jeuceduhnisch/euroclock-slicer/hardware/examples/build-photos/07-preset-save-menu.jpg

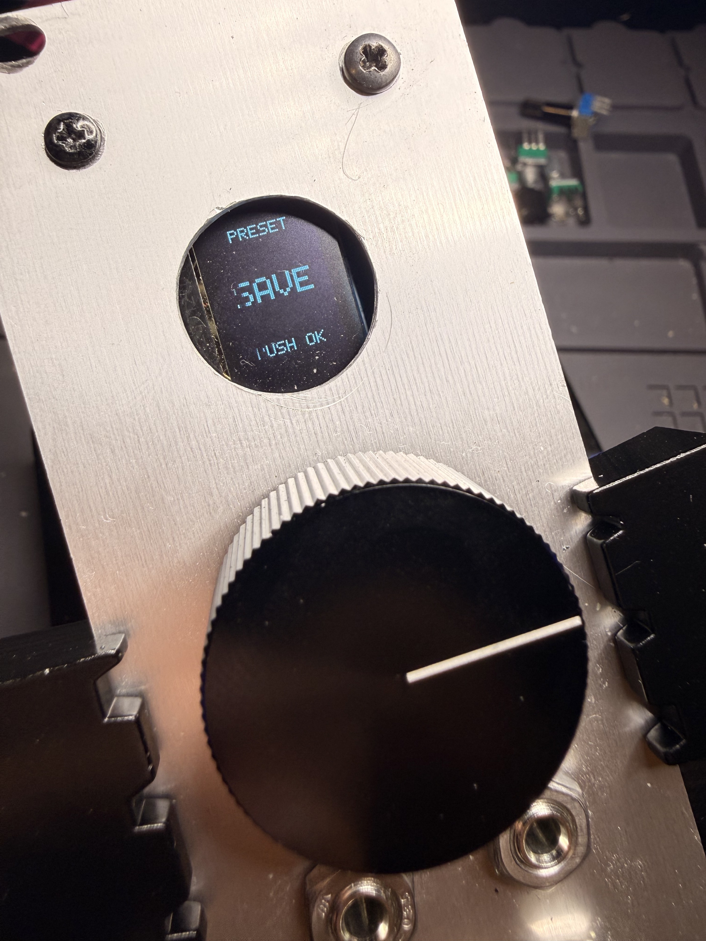
hardware/examples/build-photos/07-preset-save-menu.jpg
