jeuceduhnisch/euroclock-slicer/hardware/examples/build-photos/05-output-menu-time.jpg

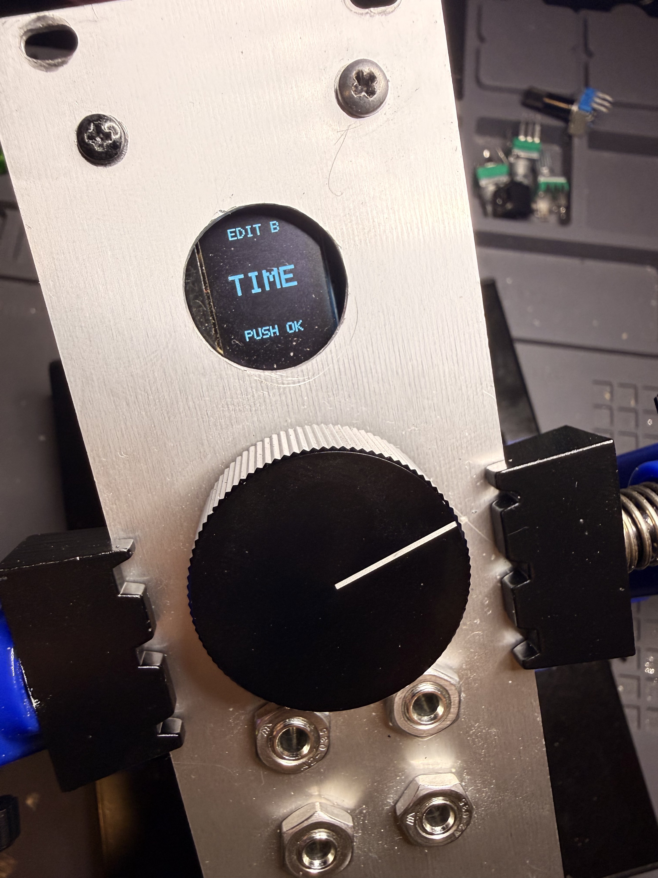
hardware/examples/build-photos/05-output-menu-time.jpg
