jeuceduhnisch/euroclock-slicer/hardware/examples/build-photos/01-front-panel-home.jpg

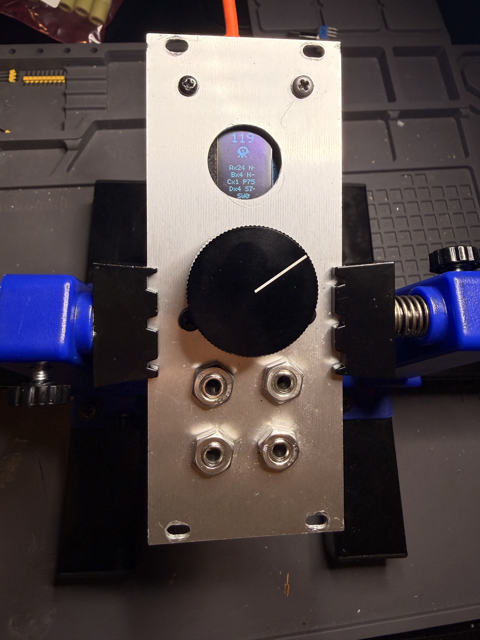
hardware/examples/build-photos/01-front-panel-home.jpg
