jeuceduhnisch/euroclock-slicer/hardware/examples/build-photos/02-main-board-wiring.jpg

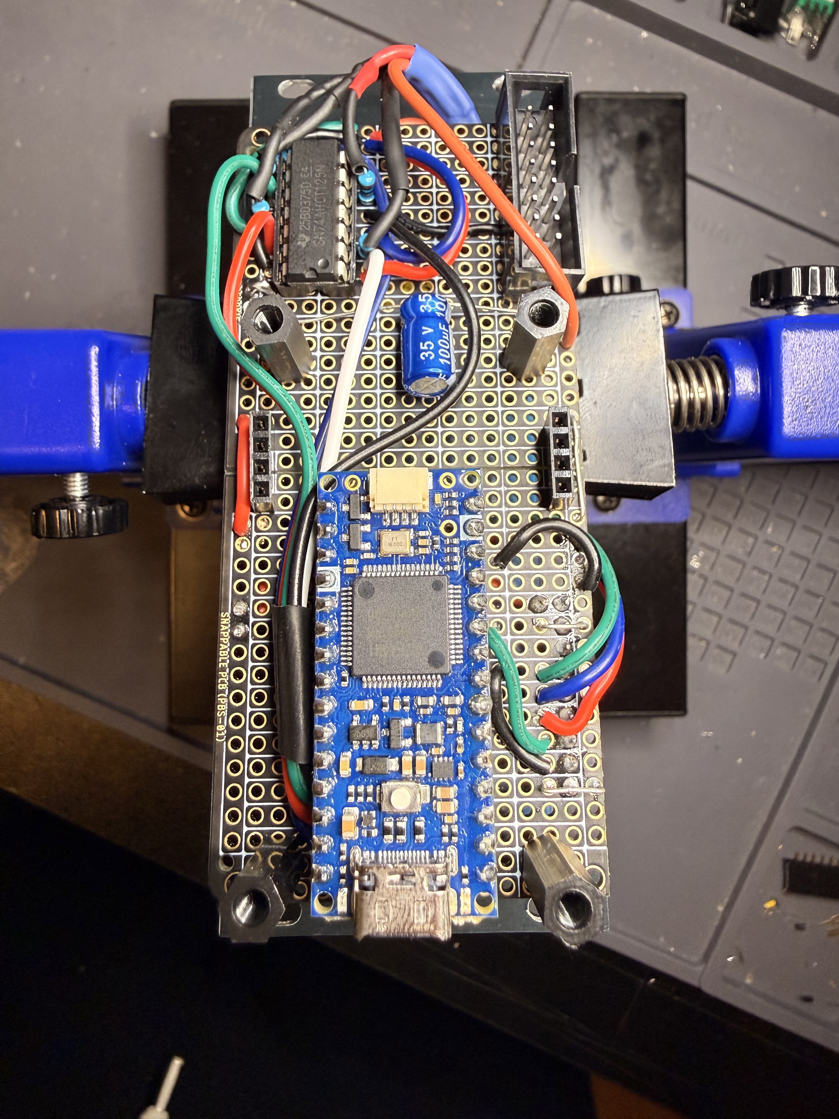
hardware/examples/build-photos/02-main-board-wiring.jpg
