jeuceduhnisch/euroclock-slicer/hardware/examples/build-photos/03-side-stack-profile.jpg

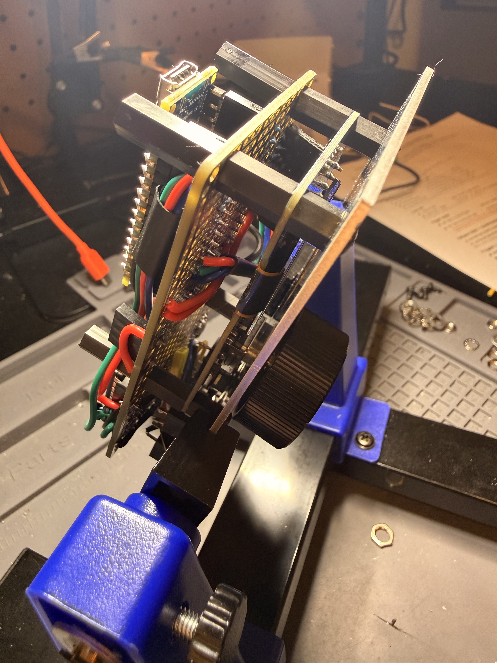
hardware/examples/build-photos/03-side-stack-profile.jpg
