jeuceduhnisch/euroclock-slicer/hardware/examples/build-photos/04-jack-wiring-detail.jpg

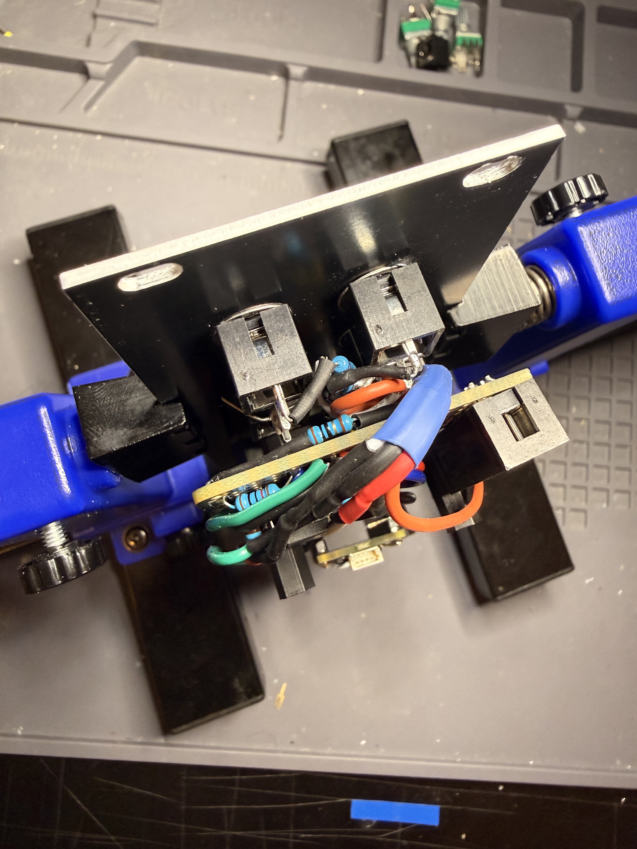
hardware/examples/build-photos/04-jack-wiring-detail.jpg
