jeuceduhnisch/euroclock-slicer/hardware/examples/build-photos/06-pattern-menu-slicer.jpg

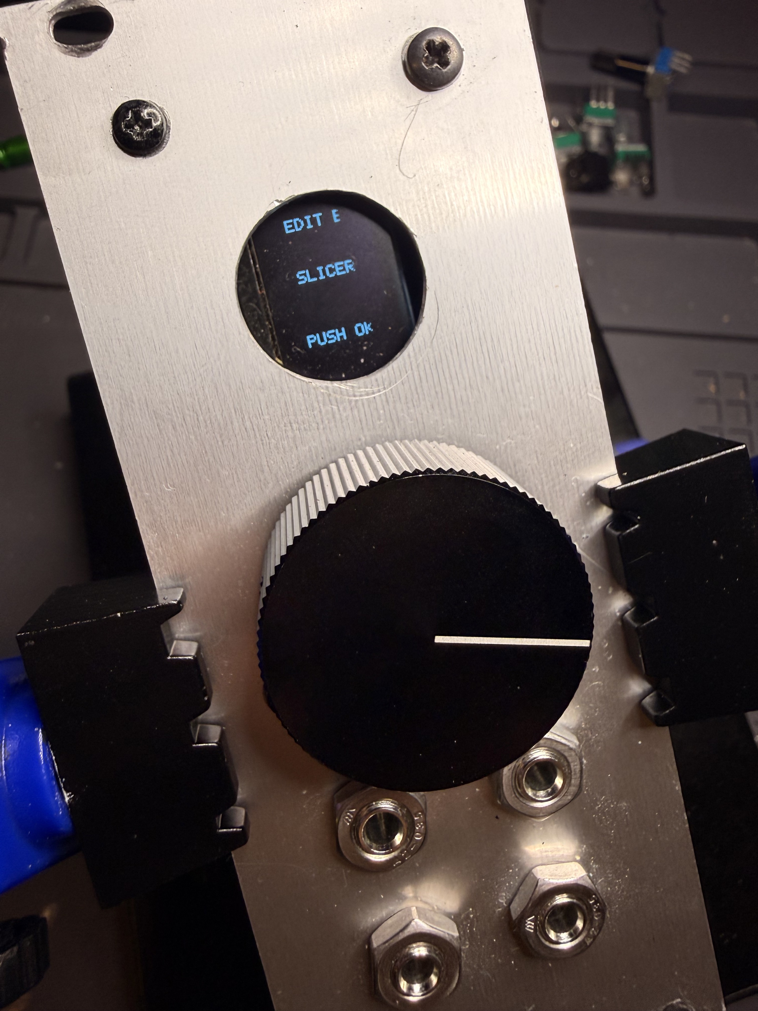
hardware/examples/build-photos/06-pattern-menu-slicer.jpg
